ryron01/DualEVChargerController/hardware/perfboard/perfboard-guide.html

# EV Charger Perfboard

24 × 30 plain perfboard · 37 wires · from the bench netlist

Parts go on the top. Every connection is an insulated wire on the bottom, soldered at both ends. Holes are named by column letter and row number, as on the board edges. The bottom view is mirrored, so it matches the board when you flip it left to right. Click a wire in the lists to find it on both views.

Mains zone. The hatched area (columns A–I, rows 1–7) carries 120 V from J1 to the HLK-PM01. The board has no fuse of its own, so feed J1 only from the inline 1 A fuse. Use insulated wire rated 300 V or more there, and run nothing else through it. Low-voltage parts and wires stay at least 10 mm from any mains hole.

Wire. 24–26 AWG insulated (silicone or PTFE) for low voltage; 20 AWG rated 300 V for mains. Wires may cross each other on the bottom; the routes shown avoid other nets' pads.

Diodes. The band (cathode) faces the PZEM header: D1 band at W12, D2 band at W17. Reversed diodes put 5 V on GPIO16 and block replies.

Modules on headers. The ESP32 and level shifter sit in female headers. Unused ESP32 pins still get a header socket; some wires pass under those joints on the bottom.

## Board views

AC_LAC_N+5VGND+3V3PZEM_TXPZEM1_TXPZEM2_TXPZEM_RXRELAY1RELAY2SW1SW2SDA_3V3SCL_3V3SDA_5VSCL_5V

Top, component side. Wires shown dashed, as if seen through the board.

Bottom, wiring side (mirrored). Flip the board left to right to match.

## Step 1: Place and solder parts

Done | Part | What | Holes
| D1 | BAT43 Schottky | Cathode band at W12 (next to PZEM1 TX), anode at W15
| D2 | BAT43 Schottky | Cathode band at W17 (next to PZEM2 TX), anode at W20
| R1 | 10 kΩ | V19 (3V3 side) to V15 (diode junction), standing or flat
| U1 | 2 × 1×19 female headers for the ESP32 | Inner row C20–U20 (5V end at C20, 3V3 at U20); outer row C30–U30. USB faces the left edge.
| U2 | 2 × 1×6 female headers for the level shifter | HV row P10–U10 (HV1 at P10), LV row P14–U14
| J4 | 1×4 header, LCD | GND N10, VCC N11, SDA N12, SCL N13
| J2 | 1×4 header, PZEM1 | VCC X10, RX X11, TX X12, GND X13
| J3 | 1×4 header, PZEM2 | VCC X15, RX X16, TX X17, GND X18
| J5 | 1×3 header, relay 1 | DC+ K18, DC− L18, IN M18
| J6 | 1×3 header, relay 2 | DC+ G18, DC− H18, IN I18
| J7 | 1×3 header, panel buttons | SW2 N18, SW1 O18, GND P18 (pin 1 = GND at the right end)
| J1 | 2-way 5.08 mm screw terminal, AC in from the inline fuse | L B2, N B4
| PS1 | HLK-PM01 | AC1 I4, AC2 I6, −Vo U2, +Vo U8. Its pins are 29.4 mm end to end and the holes 30.5 mm, so bend each pin out about 0.5 mm.

Solder the lowest parts first: diodes and resistor, then headers and the terminal, then the HLK-PM01.

## Wiring

Clear all ticks

### Step 2: Mains wiring 2 wires

Done | Net | From | To | Route on the bottom
| AC_L | B2 J1.L | I4 PS1.AC1 | B2 → I2 → I4
| AC_N | B4 J1.N | I6 PS1.AC2 | B4 → B6 → I6

### Step 3: Power and ground 20 wires

Done | Net | From | To | Route on the bottom
| +5V | U8 PS1.+VO | R10 U2.HV | U8 → R8 → R10
| +5V | R10 U2.HV | N11 J4.VCC | R10 → R8 → M8 → M11 → N11
| +5V | U8 PS1.+VO | X10 J2.VCC | U8 → X8 → X10
| +5V | X10 J2.VCC | X15 J3.VCC | X10 → V10 → V14 → X14 → X15
| +5V | N11 J4.VCC | K18 J5.DC+ | N11 → K11 → K18
| +5V | K18 J5.DC+ | G18 J6.DC+ | K18 → K17 → G17 → G18
| +5V | G18 J6.DC+ | C20 U1.EXT_5V | G18 → C18 → C20
| GND | U2 PS1.-VO | S10 U2.GND@2 | U2 → S2 → S10
| GND | S10 U2.GND@2 | S14 U2.GND@1 | S10 → S14
| GND | S10 U2.GND@2 | N10 J4.GND | S10 → S9 → N9 → N10
| GND | S14 U2.GND@1 | X13 J2.GND | S14 → S13 → X13
| GND | X13 J2.GND | X18 J3.GND | X13 → U13 → U18 → X18
| GND | S14 U2.GND@1 | P18 J7.GND | S14 → S18 → P18
| GND | P18 J7.GND | L18 J5.DC- | P18 → P17 → L17 → L18
| GND | L18 J5.DC- | H18 J6.DC- | L18 → L19 → H19 → H18
| GND | H18 J6.DC- | H20 U1.GND1 | H18 → H20
| GND | P18 J7.GND | O30 U1.GND2 | P18 → P29 → O29 → O30
| GND | O30 U1.GND2 | U30 U1.GND3 | O30 → O29 → U29 → U30
| +3V3 | U20 U1.3V3 | V19 R1.1 | U20 → V20 → V19
| +3V3 | U20 U1.3V3 | R14 U2.LV | U20 → U19 → R19 → R14

### Step 4: Signals 15 wires

Done | Net | From | To | Route on the bottom
| PZEM_TX | J30 U1.IO16 | W20 D2.A | J30 → J24 → W24 → W20
| PZEM_TX | W20 D2.A | W15 D1.A | W20 → W18 → V18 → V16 → W16 → W15
| PZEM_TX | W15 D1.A | V15 R1.2 | W15 → V15
| PZEM1_TX | X12 J2.TX | W12 D1.C | X12 → W12
| PZEM2_TX | X17 J3.TX | W17 D2.C | X17 → W17
| PZEM_RX | K30 U1.IO17 | X16 J3.RX | K30 → K22 → T22 → T16 → X16
| PZEM_RX | X16 J3.RX | X11 J2.RX | X16 → T16 → T11 → X11
| RELAY1 | M20 U1.IO25 | M18 J5.IN | M20 → M18
| RELAY2 | L20 U1.IO26 | I18 J6.IN | L20 → L21 → I21 → I18
| SW1 | O20 U1.IO32 | O18 J7.SW1 | O20 → O18
| SW2 | N20 U1.IO33 | N18 J7.SW2 | N20 → N18
| SDA_3V3 | S30 U1.IO22 | P14 U2.LV1 | S30 → S25 → B25 → B14 → P14
| SCL_3V3 | T30 U1.IO23 | Q14 U2.LV2 | T30 → T23 → Q23 → Q14
| SDA_5V | P10 U2.HV1 | N12 J4.SDA | P10 → P12 → N12
| SCL_5V | Q10 U2.HV2 | N13 J4.SCL | Q10 → Q13 → N13

## Before the first power-up

1. With nothing plugged in, check for no continuity between J1 L or N and any low-voltage point: +5V, GND, 3V3.
2. Check no continuity between +5V and GND, or between 3V3 and GND.
3. Check continuity from each header pin to its ESP32 socket, using the wire list.
4. Feed J1 through the inline fuse from the GFCI bench feed, with the ESP32 and modules out, and measure 5 V at J4 VCC.
5. Power off, fit the ESP32 and level shifter, power up and confirm the D1/D2 anode junction reads about 3.3 V.
