ryron01/DualEVChargerController/docs/bench-wiring.png

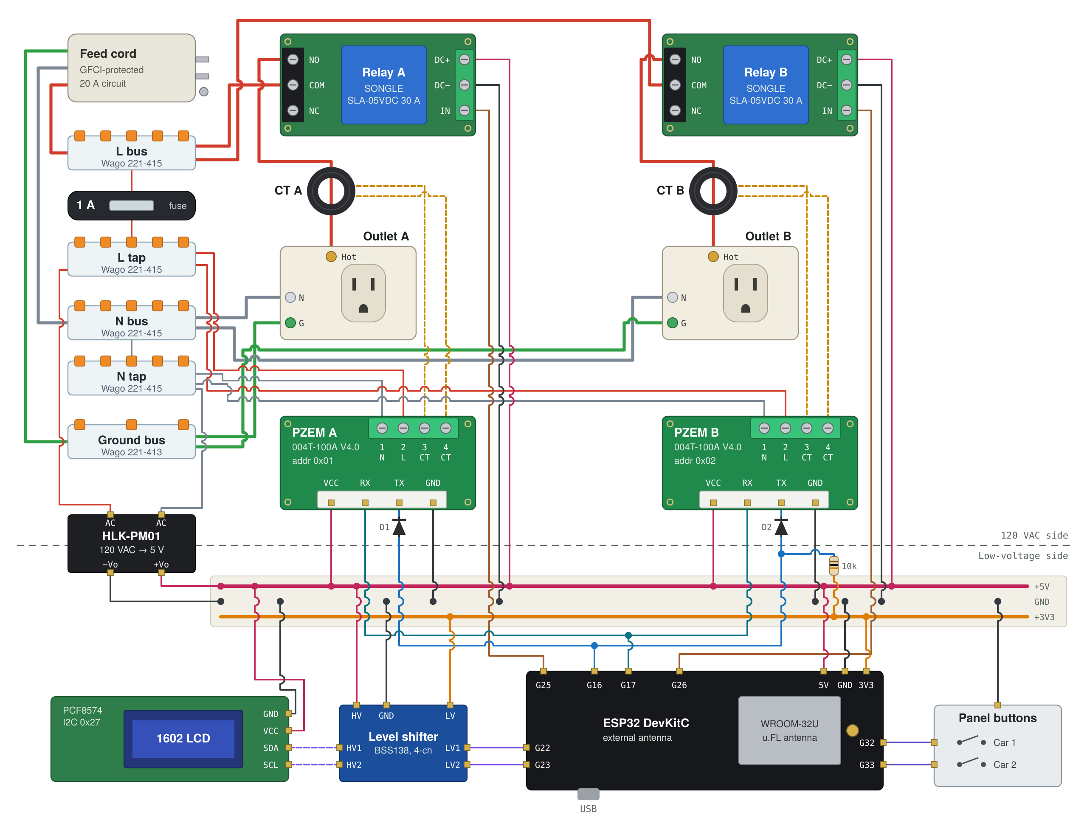
docs/bench-wiring.png
