ryron01/DualEVChargerController/hardware/ev-charger-controller.sch

## EAGLE design hardware/ev-charger-controller.sch (2026-11-10)

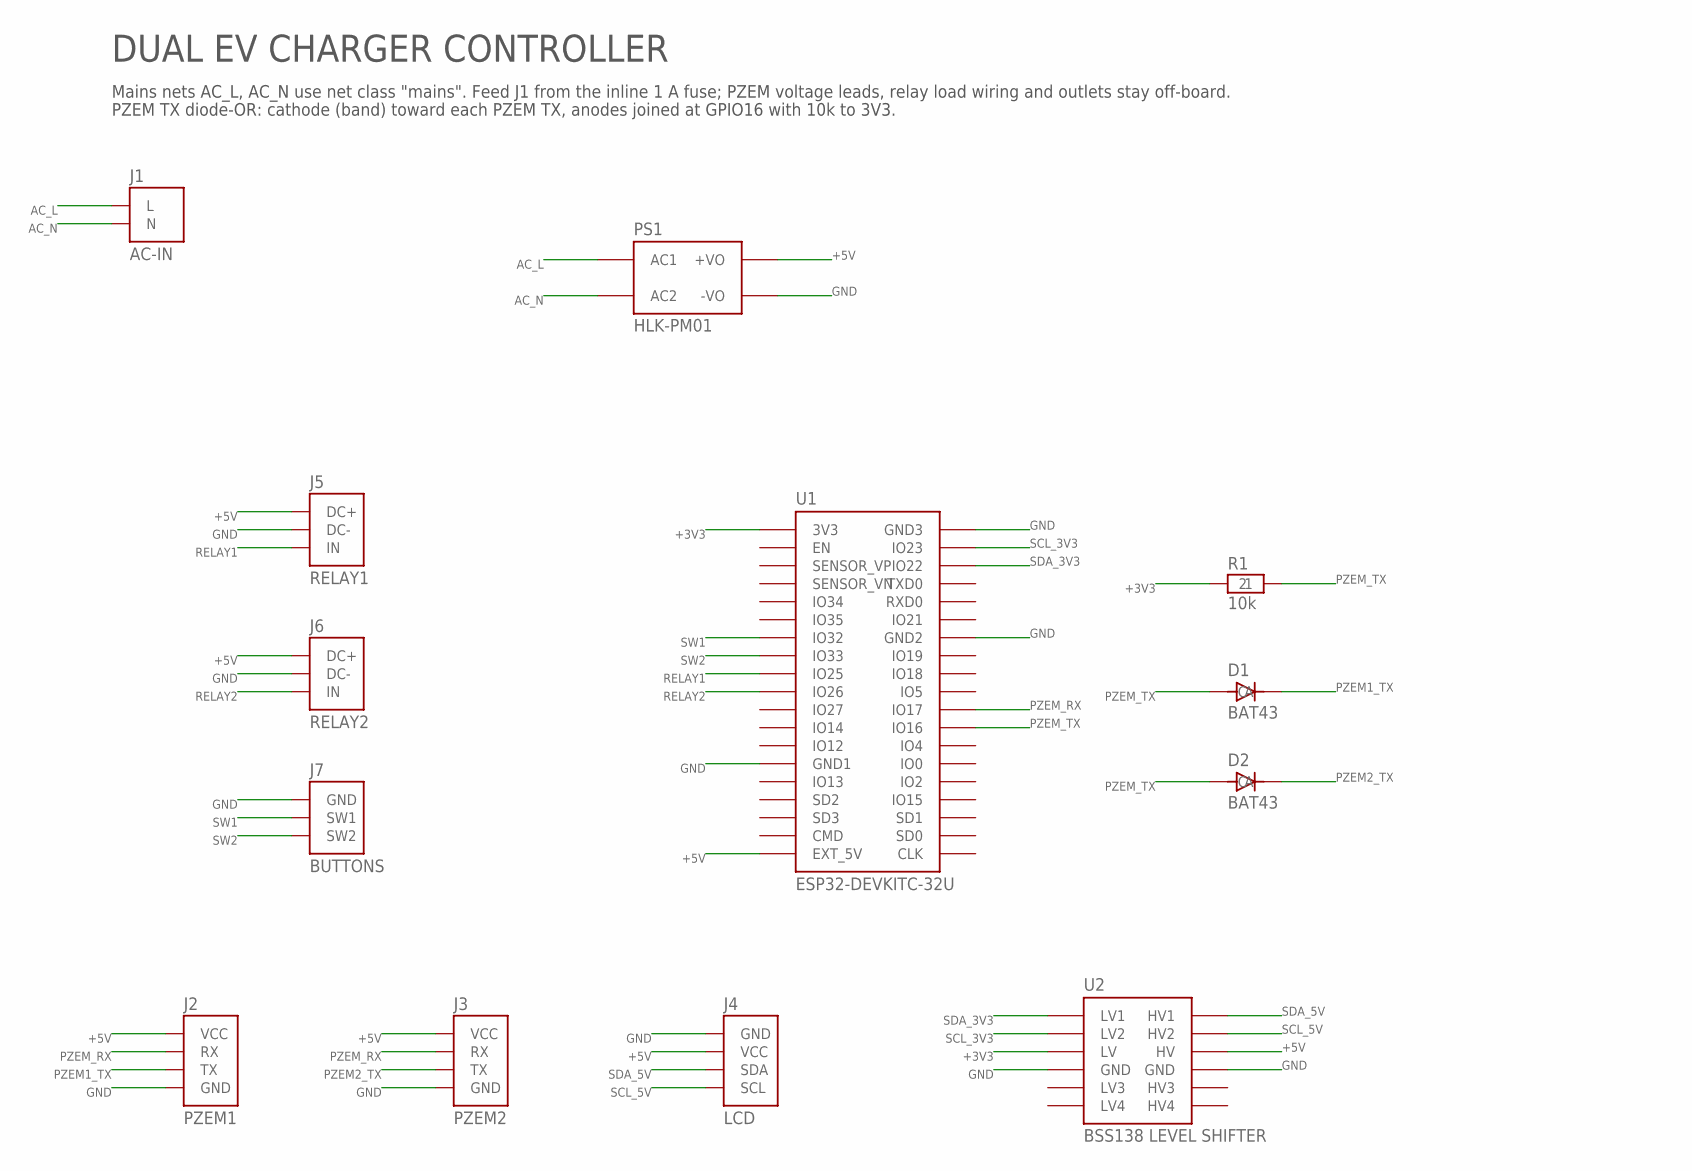
[picture p3: schematic ev-charger-controller.sch]

Parts:
D1, D2: BAT43; DO-35
J1: AC-IN; TERM-2-5.08
J2: PZEM1; PINHD-1X4
J3: PZEM2; PINHD-1X4
J4: LCD; PINHD-1X4
J5: RELAY1; PINHD-1X3
J6: RELAY2; PINHD-1X3
J7: BUTTONS; PINHD-1X3
PS1: HLK-PM01; CONV_HLK-PM01
R1: 10k; R-0207-10.16
U1: ESP32-DEVKITC-32U; MODULE_ESP32-DEVKITC
U2: BSS138 LEVEL SHIFTER; BSS138-4CH-MODULE

Connections:
+3V3: R1.1, U1.1 (3V3), U2.3 (LV)
+5V: J2.1 (VCC), J3.1 (VCC), J4.2 (VCC), J5.1 (DC+), J6.1 (DC+), PS1.4 (+VO), U1.19 (EXT_5V), U2.9 (HV)
AC_L: J1.1 (L), PS1.1 (AC1)
AC_N: J1.2 (N), PS1.2 (AC2)
GND: J2.4 (GND), J3.4 (GND), J4.1 (GND), J5.2 (DC-), J6.2 (DC-), J7.1 (GND), PS1.3 (-VO), U1.14 (GND1), U1.32 (GND2), U1.38 (GND3), U2.4 (GND), U2.10 (GND)
PZEM1_TX: D1.C, J2.3 (TX)
PZEM2_TX: D2.C, J3.3 (TX)
PZEM_RX: J2.2 (RX), J3.2 (RX), U1.28 (IO17)
PZEM_TX: D1.A, D2.A, R1.2, U1.27 (IO16)
RELAY1: J5.3 (IN), U1.9 (IO25)
RELAY2: J6.3 (IN), U1.10 (IO26)
SCL_3V3: U1.37 (IO23), U2.2 (LV2)
SCL_5V: J4.4 (SCL), U2.8 (HV2)
SDA_3V3: U1.36 (IO22), U2.1 (LV1)
SDA_5V: J4.3 (SDA), U2.7 (HV1)
SW1: J7.2 (SW1), U1.7 (IO32)
SW2: J7.3 (SW2), U1.8 (IO33)

Notes on the sheet:
DUAL EV CHARGER CONTROLLER
Mains nets AC_L, AC_N use net class "mains". Feed J1 from the inline 1 A fuse; PZEM voltage leads, relay load wiring and outlets stay off-board.
PZEM TX diode-OR: cathode (band) toward each PZEM TX, anodes joined at GPIO16 with 10k to 3V3.
