ryron01/DualEVChargerController/ev-charger.yaml

esphome:
  name: ev-charger
  friendly_name: EV Charger Controller

esp32:
  board: esp32dev
  framework:
    type: arduino

logger:

api:
  encryption:
    key: !secret api_key

ota:
  - platform: esphome
    password: !secret ota_password

wifi:
  ssid: !secret wifi_ssid
  password: !secret wifi_password
  ap:
    ssid: "EV-Charger Fallback"
    password: !secret fallback_password

# ── DISPLAY ──────────────────────────────────────────────────────────
i2c:
  sda: GPIO22
  scl: GPIO23
  scan: true

display:
  - platform: lcd_pcf8574
    dimensions: 16x2
    address: 0x27
    update_interval: 300ms
    user_characters:
        # NOTE: position 0 is accessed as \x08 in lambdas, NOT \x00
        # ESPHome maps position 0 to \x08 to avoid the C null terminator issue
      - position: 0
        data: [0x0A, 0x0A, 0x1F, 0x11, 0x11, 0x0E, 0x04, 0x04]  # \x08 plug
      - position: 1
        data: [0x00, 0x00, 0x00, 0x00, 0x00, 0x04, 0x0A, 0x11]  # \x01 chg1
      - position: 2
        data: [0x00, 0x00, 0x04, 0x0A, 0x11, 0x04, 0x0A, 0x11]  # \x02 chg2
      - position: 3
        data: [0x04, 0x0A, 0x11, 0x04, 0x0A, 0x11, 0x00, 0x00]  # \x03 chg3
      - position: 4
        data: [0x04, 0x0A, 0x11, 0x00, 0x00, 0x00, 0x00, 0x00]  # \x04 chg4
      - position: 6
        data: [0x0E, 0x11, 0x11, 0x1F, 0x1B, 0x1B, 0x1F, 0x00]  # \x06 lock
      - position: 7
        data: [0x00, 0x00, 0x01, 0x03, 0x16, 0x1C, 0x08, 0x00]  # \x07 checkmark

    lambda: |-
      uint32_t phase = (millis() / 300) % 5;

      // Cycle through chg1-chg4 (positions 1-4 = \x01-\x04); phase 4 repeats chg1
      const char* chg;
      switch(phase) {
        case 0: chg = "\x01"; break;  // chg1
        case 1: chg = "\x02"; break;  // chg2
        case 2: chg = "\x03"; break;  // chg3
        case 3: chg = "\x04"; break;  // chg4
        default: chg = "\x01"; break;
      }

      // Interlock fault — highest priority
      if (id(outlet1_current).state > 0.5 &&
          id(outlet2_current).state > 0.5) {
        if (phase < 3) {
          it.printf(0, 0, "\x06 LOCKED        ");
          it.printf(0, 1, "SIMULTANEOUS CHG");
        } else {
          it.printf(0, 0, "                ");
          it.printf(0, 1, "                ");
        }

      // Car 1 charging
      } else if (id(relay1).state && id(outlet1_pf)->state && outlet1_pf->state > .3 && id(outlet1_current).state > .5) {
        it.printf(0, 0, "\x08""1:%4.1fA %s CHRG",
          id(outlet1_current).state, chg);
        it.printf(0, 1, "\x08""2:%4.1fA OFF   ",
          id(outlet2_current).state);

      // Car 2 charging
      } else if (id(relay2).state && id(outlet2_pf)->state && outlet2_pf->state > .3 && id(outlet2_current).state > .5) {
        it.printf(0, 0, "\x08""1:%4.1fA OFF   ",
          id(outlet1_current).state);
        it.printf(0, 1, "\x08""2:%4.1fA %s CHRG",
          id(outlet2_current).state, chg);
      
      // Car 1 done charging
      } else if (id(outlet1_pf)->state && outlet1_pf->state < .3 && id(outlet1_current).state < 2) {
        it.printf(0, 0, "\x08""1:%4.1fA \x07    ",
          id(outlet1_current).state);
        it.printf(0, 1, "\x08""2:%4.1fA OFF   ",
          id(outlet2_current).state);
      
      // Car 2 done charging
      } else if (id(outlet2_pf)->state && outlet2_pf->state < .3 && id(outlet2_current).state < 2) {
        it.printf(0, 0, "\x08""1:%4.1fA OFF   ",
          id(outlet1_current).state);
        it.printf(0, 1, "\x08""2:%4.1fA \x07    ",
          id(outlet2_current).state);

      // Neither charging — show relay state
      } else {
        it.printf(0, 0, "\x08""1:%4.1fA %s",
          id(outlet1_current).state,
          id(relay1).state ? "ON     " : "OFF    ");
        it.printf(0, 1, "\x08""2:%4.1fA %s",
          id(outlet2_current).state,
          id(relay2).state ? "ON     " : "OFF    ");
      }

# ── CHARGE TRACKING ──────────────────────────────────────────────────
# Set when an outlet draws charging current while its relay is on, and
# cleared each time the relay turns on. Lets the status sensors tell
# "waiting for the car to start" apart from "car finished".
globals:
  - id: car1_has_charged
    type: bool
    restore_value: no
    initial_value: 'false'
  - id: car2_has_charged
    type: bool
    restore_value: no
    initial_value: 'false'

# ── UART + PZEM ──────────────────────────────────────────────────────
uart:
  id: pzem_uart
  tx_pin: GPIO17
  rx_pin: GPIO16
  baud_rate: 9600
  stop_bits: 1

modbus:
  uart_id: pzem_uart
  id: mod_bus

sensor:
  - platform: pzemac
    modbus_id: mod_bus
    address: 1
    update_interval: 10s
    current:
      name: "Car 1 Current"
      id: outlet1_current
      on_value:
        then:
          - lambda: |-
              if (id(relay1).state && x > 0.5) id(car1_has_charged) = true;
    voltage:
      name: "Car 1 Voltage"
    power:
      name: "Car 1 Power"
    energy:
      name: "Car 1 Energy"
    frequency:
      name: "Car 1 Frequency"
    power_factor:
      name: "Car 1 Power Factor"
      id: outlet1_pf

  - platform: pzemac
    modbus_id: mod_bus
    address: 2
    update_interval: 10s
    current:
      name: "Car 2 Current"
      id: outlet2_current
      on_value:
        then:
          - lambda: |-
              if (id(relay2).state && x > 0.5) id(car2_has_charged) = true;
    voltage:
      name: "Car 2 Voltage"
    power:
      name: "Car 2 Power"
    energy:
      name: "Car 2 Energy"
    frequency:
      name: "Car 2 Frequency"
    power_factor:
      name: "Car 2 Power Factor"
      id: outlet2_pf

# ── TEXT SENSORS ──────────────────────────────────────────────────────
text_sensor:
  - platform: template
    name: "Car 1 Status"
    id: outlet1_status
    lambda: |-
      if (id(relay1).state && id(outlet1_current).state > 0.5)
        return {"Charging"};
      else if (id(relay1).state && id(car1_has_charged))
        return {"Done Charging"};
      else if (id(relay1).state)
        return {"Waiting for Car"};
      else
        return {"Idle"};
    update_interval: 10s

  - platform: template
    name: "Car 2 Status"
    id: outlet2_status
    lambda: |-
      if (id(relay2).state && id(outlet2_current).state > 0.5)
        return {"Charging"};
      else if (id(relay2).state && id(car2_has_charged))
        return {"Done Charging"};
      else if (id(relay2).state)
        return {"Waiting for Car"};
      else
        return {"Idle"};
    update_interval: 10s

  - platform: template
    name: "Interlock Status"
    lambda: |-
      if (id(outlet1_current).state > 0.5 && id(outlet2_current).state > 0.5)
        return {"Locked - Simultaneous Draw"};
      else
        return {"OK"};
    update_interval: 5s


# ── BINARY SENSORS ────────────────────────────────────────────────────
binary_sensor:
  - platform: template
    name: "Simultaneous Charge Detected"
    id: interlock_fault
    lambda: |-
      return id(outlet1_current).state > 0.5 &&
             id(outlet2_current).state > 0.5;
    device_class: problem

  # Momentary button to GND: each press toggles car 1's outlet. Turning it on
  # turns car 2's off through the relay interlock below.
  - platform: gpio
    pin:
      number: GPIO32
      mode: INPUT_PULLUP
      inverted: true
    name: "Panel Button Car 1"
    id: button_outlet1
    filters:
      - delayed_on: 30ms
      - delayed_off: 30ms
    on_press:
      - switch.toggle: relay1

  # Momentary button to GND: each press toggles car 2's outlet. Turning it on
  # turns car 1's off through the relay interlock below.
  - platform: gpio
    pin:
      number: GPIO33
      mode: INPUT_PULLUP
      inverted: true
    name: "Panel Button Car 2"
    id: button_outlet2
    filters:
      - delayed_on: 30ms
      - delayed_off: 30ms
    on_press:
      - switch.toggle: relay2

# ── RELAYS ────────────────────────────────────────────────────────────
switch:
  - platform: gpio
    pin:
      number: GPIO25
      inverted: false
    name: "Car 1 Switch"
    id: relay1
    restore_mode: ALWAYS_OFF
    on_turn_on:
      # Layer 1 interlock: relay 1 on forces relay 2 off
      - switch.turn_off: relay2
      - lambda: 'id(car1_has_charged) = false;'

  - platform: gpio
    pin:
      number: GPIO26
      inverted: false
    name: "Car 2 Switch"
    id: relay2
    restore_mode: ALWAYS_OFF
    on_turn_on:
      # Layer 1 interlock: relay 2 on forces relay 1 off
      - switch.turn_off: relay1
      - lambda: 'id(car2_has_charged) = false;'

# ── INTERLOCK ─────────────────────────────────────────────────────────
# Scheduling and handoff between cars live in Home Assistant automations,
# so they can change without reflashing. Safety interlocks stay on the device.
interval:
  - interval: 5s
    then:
      # Layer 2 interlock — current-sense simultaneous draw detection
      - if:
          condition:
            lambda: |-
              return id(outlet1_current).state > 0.5 &&
                     id(outlet2_current).state > 0.5;
          then:
            - switch.turn_off: relay2
            - logger.log:
                level: WARN
                format: "Simultaneous draw detected (C1:%.1fA C2:%.1fA) — cut relay 2"
                args: ['id(outlet1_current).state', 'id(outlet2_current).state']
