ryron01/DualEVChargerController/(commit log)

2026-11-05 Initial commit: dual EV charger controller
    ESPHome firmware for two Level 1 chargers sharing one 20 A circuit,
    PZEM Modbus tools, bench wiring diagram and README.
    Claude-Session: https://claude.ai/code/session_01PP3kUehqaYH9eies5uiSvd
2026-11-05 Fix LCD car 2 done line and add waiting state to charge status
    - LCD: the "car 2 done charging" branch printed car 2's current on the
    line labeled 1 and car 1's on line 2. Each line now shows its own car.
    - Status: "Done Charging" was reported whenever a relay was on with no
    current, including before the car started drawing. A per-outlet flag
    now records whether the car charged since its relay turned on, and
    the status reads "Waiting for Car" until it has.
    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
    [ev-charger.yaml]
2026-11-07 Add BSS138 level shifter between the ESP32 and the LCD backpack
    The PCF8574 backpack pulls SDA/SCL up to 5 V, above the ESP32's
    3.6 V limit, and needs 3.5 V for a logic high at 5 V supply. Route
    I2C through a level shifter and document it in the wiring diagram,
    README pin map, wiring notes and parts list.
    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
2026-11-07 Document setting PZEM B to Modbus address 0x02
    Step-by-step procedure in the shared UART section: isolate the module,
    wire a USB-to-TTL adapter, power the AC side, check, write and verify
    the address with the tools/pzem scripts.
    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
2026-11-08 Get both PZEMs working on the shared UART
    Both modules now answer on one bus. Document what made it work:
    - PZEM interface VCC on 5 V; the RX optocoupler doesn't switch
    reliably at 3.3 V.
    - Schottky diode-OR on TX, cathode toward each PZEM, anodes joined at
    GPIO16 with 10k to 3V3. Without diodes each module's 4.7k pull-up
    overpowers the other's optocoupler.
    - RX wired directly from GPIO17.
    Update the wiring diagram, README and wiring page to match, add the
    diodes and pull-up to the parts list, and record the LCD level-shifter
    issue as still open.
    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
2026-11-08 Move charging handoff out of the firmware
    The on-device handoff switched to the other outlet whenever the active
    one drew under 0.5 A for 60 s, so two outlets with no load flipped back
    and forth indefinitely. Remove it and leave handoff to Home Assistant
    automations, which can change without reflashing. Both interlock layers
    stay on the device.
    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
    [ev-charger.yaml]
2026-11-08 Move charging schedule to Home Assistant
    Remove the on-device schedule, the four input_datetime helpers it read
    and the Home Assistant time sync only it used. Scheduling now runs as
    Home Assistant automations, so it can change without reflashing. The
    device keeps both interlock layers and works as a pair of interlocked
    switches if Home Assistant is down.
    Document the entities automations use and how to trigger a handoff
    without the empty-outlet loop.
    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
2026-11-08 Remove unused LCD character and fix glyph comments
    Drop the blank custom character at position 5 and the commented-out
    case that referenced it; the animation already repeated chg1 for that
    phase. Correct the comments on positions 3 and 4.
    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
    [ev-charger.yaml]
2026-11-08 Remove UART debug logging
    The raw Modbus traffic logging was for diagnosing the shared PZEM bus,
    which now works. Drop it from the firmware and document in the README
    how to turn it back on for troubleshooting.
    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
2026-11-08 Add generated PCB schematic for the carrier board
    EAGLE schematic matching the bench build, generated from code with an
    embedded parts library, so it imports into Fusion without depending on
    its libraries. Includes the Schottky diode-OR on PZEM TX, PZEM VCC on
    5 V, the LCD level shifter, panel switches, and a fused mains tap for
    the HLK-PM01 and PZEM voltage inputs in a "mains" net class.
    tools/schematic has the generator, an independent netlist and geometry
    check, and a preview renderer. Every pin connects through its own named
    stub, which avoids the merged nets in the earlier Fusion documents.
    Claude-Session: https://claude.ai/code/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
    [ev-charger-controller.sch]
2026-11-08 Model the level shifter as one 2x6 module in the schematic
    Replace the two separate 1x6 headers with a single BSS138 module part,
    so the PCB footprint keeps the LV and HV rows aligned. Pin order taken
    from the module's silkscreen: 1, 2, V, GND, 3, 4 per row, HVn across
    from LVn. The checker now also confirms that alignment.
    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
    [ev-charger-controller.sch]
2026-11-08 Add perfboard layout and soldering guide
    Lay out the controller on a 24x30 plain perfboard from the same netlist
    as the schematic: parts placed by hole, insulated point-to-point wiring
    on the bottom, mains confined to a zone with 10 mm to low voltage.
    Includes top and mirrored bottom views, an interactive soldering guide
    with a tick-off wire list, and an independent connectivity and
    clearance check.
    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
    [make_guide.py, perfboard.py, render_perfboard.py, verify_perfboard.py]
2026-11-09 Drop on-board PZEM AC terminals and fuse
    The PZEM voltage leads connect straight to the PZEM modules and the
    fuse is inline, so J10, J11 and F1 come off the board. The only mains
    left on the board is J1 feeding the HLK-PM01, which must be fed from
    the inline fuse. Regenerate the schematic, perfboard layout and guide,
    shrink the perfboard mains zone, and update the README and parts list.
    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
    [ev-charger-controller.sch]
2026-11-10 Use momentary buttons for the panel controls
    Each press of a panel button now toggles that car's outlet, debounced
    by 30 ms, instead of holding the relay on only while the input is
    closed. Turning one outlet on still turns the other off through the
    relay interlock. The binary sensors are renamed "Panel Button Car N".
    Update the README, schematic value and perfboard guide to match.
    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
    [ev-charger-controller.sch]
2026-11-10 Bench wiring page: panel buttons instead of switches
    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
